calvin-young/print-carriage-hack/images/IMG_8982.jpg

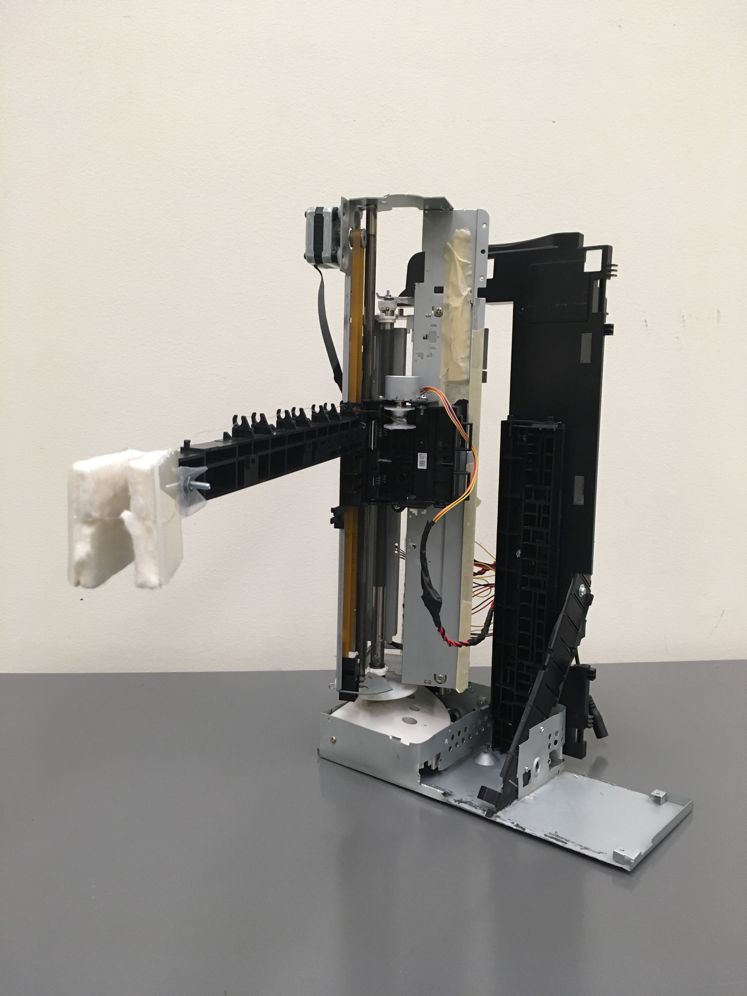
images/IMG_8982.jpg
