calvin-young/print-carriage-hack/images/IMG_8987.jpg

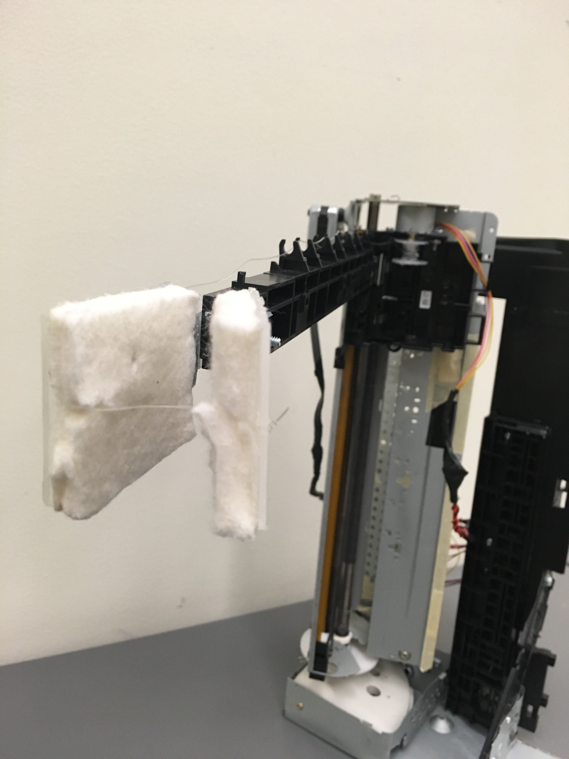
images/IMG_8987.jpg
