calvin-young/print-carriage-hack/images/IMG_8993.jpg

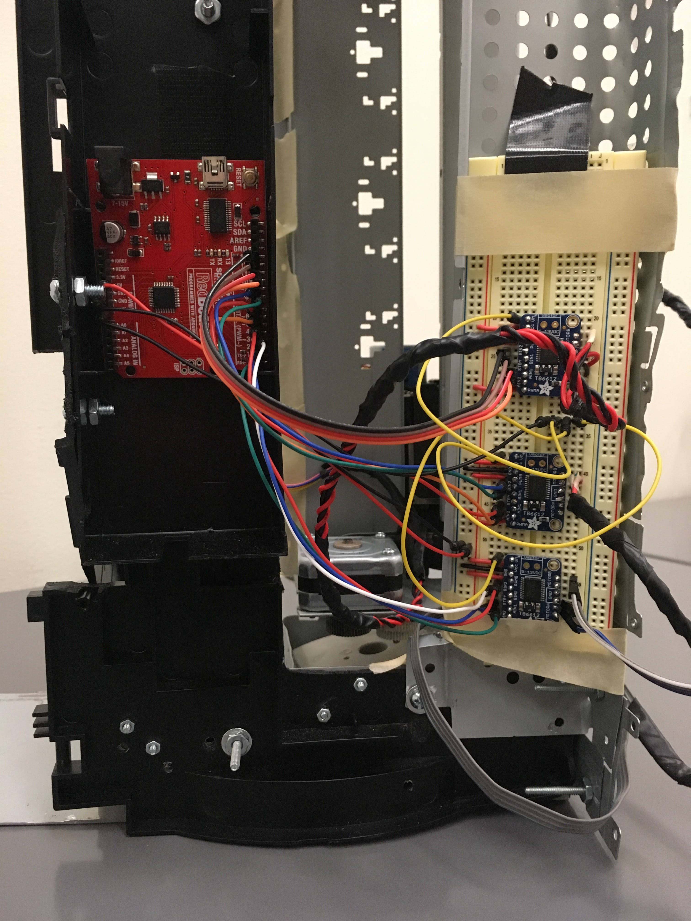
images/IMG_8993.jpg
