calvin-young/print-carriage-hack/BOM .pdf

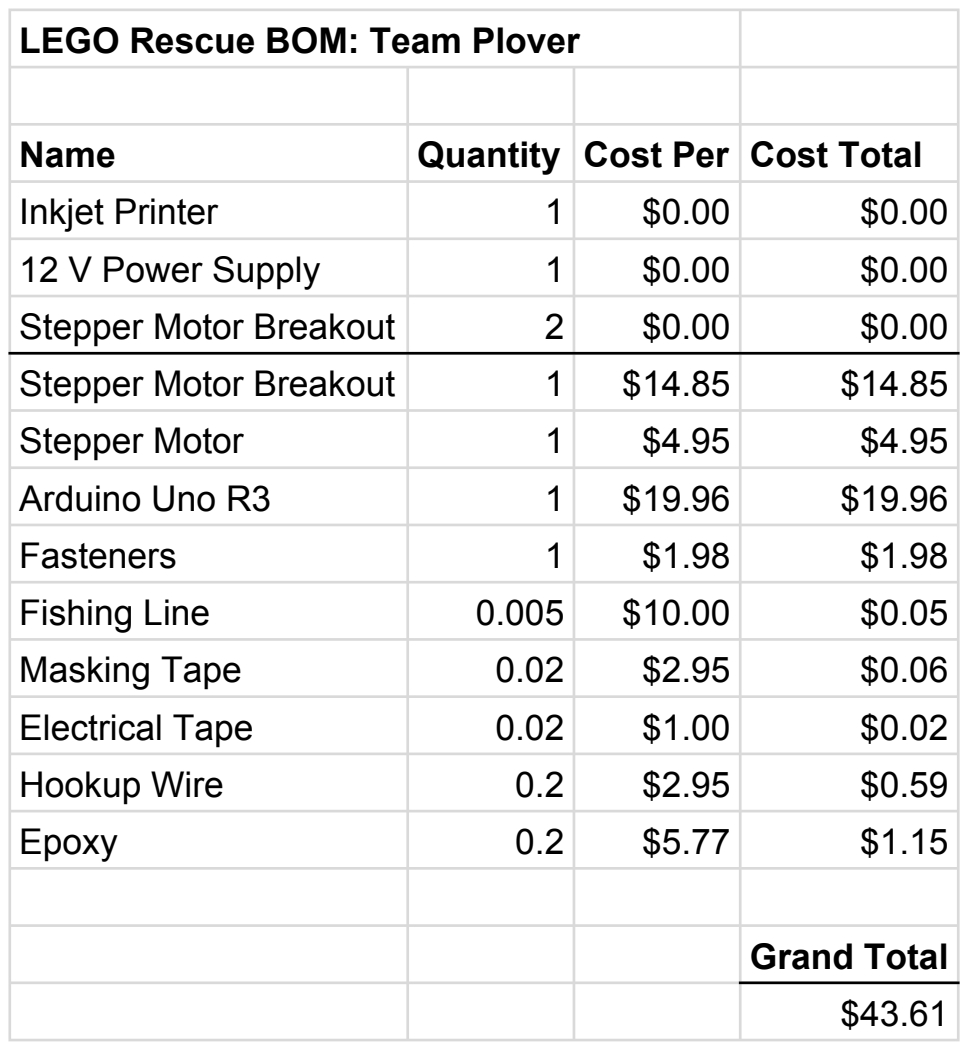
[picture p15: page 1]
Name; Quantity Cost Per Cost Total; Inkjet Printer; 12 V Power Supply; Stepper Motor Breakout; Stepper Motor; Arduino Uno R3; Fasteners; Fishing Line; Masking Tape; Electrical Tape; Hookup Wire; Epoxy; Grand Total

LEGO Rescue BOM: Team Plover
